button-engineer/Processor-on-Transistors/docs/ISA-and-opportunities-ALU.docx

Набір інструкцій та можливості ALU

Як я вже писав в цьому 4-бітному процесорі будуть 8-бітні інструкції. Ось приклад вигляду інструкції:

10110100

1011 – це команда (Opcode) наприклад команда додати ADD, саме за допомогою цих 4-х бітів процесор розуміє що потрібно робити. Так як на команду виділено 4 біта то максимум може існувати 16 команд.

01 – так як 1011 це команда додати то далі процесор має дізнатись які числа додавати, тому 01 це номер регістра з якимось числом, так як на номер виділено тільки 2 біти то всього буде 4 регістра.

00 – це також номер регістра з числом.

Але процесору ще потрібно кудась записати результат додавання, так як в інструкції більше немає зайвих бітів для позначення третього регістра для зберігання результату, процесор буде зберігати в перший регістр в інструкції тобто в регістр 01.

Далі в таблиці я розписав які команди будуть в цьому процесорі.

Команда | Назва | Синтаксис | Пояснення
0000 | NOP | NOP (00000000) | Нічого не робить, просто пропускає один такт, може використовуватись для затримок.
0001 | LD | LD R1 [R3] (00010100 00000011) | Команда яка передає число з SRAM в регістр. Комірка памʼяті SRAM позначається [Rn], n – це номер регістра. Так як з 8 біт інструкції 4 займає інструкція а 2 номер регістра то залишається ще 2 біти, але так як це дуже мало для памʼяті то номер регістра SRAM буде передаватись наступною інструкцією 8 біт, тобто всього доступно 256 регістрів SRAM.
0010 | ST | ST [R4] R2 (00100010 00000100) | Ця команда працює так само як і LD але передає число з регістра в SRAM.
0011 | ADD | ADD R0 R1 (00110001) | Команда що просто додає два 4-бітних числа з регістрів.
0100 | ADC | ADD R0 R1 (01000001) | Команда що додає два 4-бітних числа з регістрів враховуючи остачу минулого додавання.
0101 | SUB | SUB R0 R1 (01010001) | Команда для віднімання від значення з регістра 0 значення з регістра 1.
0110 | AND | AND R0 R1 (01100001) | Команда для виконання логічної операції AND над числами в регістрах 0 та 1.
0111 | OR | OR R0 R1 (01110001) | Команда для виконання логічної операції OR над числами в регістрах 0 та 1.
1000 | XOR | XOR R0 R1 (10000001) | Команда для виконання логічної операції XOR над числами в регістрах 0 та 1.
1001 | INC_DEC | INC_DEC R0 1/0 (10010001/0) | Команда що в залежності від числа в кінці інструкції додає або віднімає 1 від числа в вказаному регістрі і зберігає в той самий регістр.
1010 | SHF | SHF R0 1/0 (10100001/0) | Команда що в залежності від числа в кінці інструкції множить або ділить на два число в вказаному регістрі і зберігає в той самий регістр.
1011 | LDI | LDI R1 13 (10110100 00001101) | Команда що передає в вказаний регістр 4-бітне число, але так як в одній інструкції немає вільних 4-х біт то вони йдуть наступною інструкцією.
1100 | MOV | MOV R0 R1 (11000001) | Команда що переміщає число з регістра 1 в регістр 0.
1101 | JMP | JMP 123 (11010000 1100110) | Команда для перестрибування на інструкцію яка вказана в наступній інструкції, наприклад 123. Так як в процесорі буде 8-бітний лічильник в одній інструкції не вистачить вільних бітів для того щоб передати 8-бітне число, тому воно буде передаватись наступною інструкцією.
1110 | JZ | JZ R1 123 (11100100 1100110) | Команда також переносить на вказану інструкцію але за умови що в вказаному регістрі буде 0.
1111 | JC | JC 123 (11110000 1100110) | Команда також переносить на вказану інструкцію але за умови що після додавання буде переповнення.

Також спочатку я хотів добавити апаратне множення та ділення, але це виявилося доволі затратно по транзисторах, тому я вирішив програмно відтворювати ці дві операції.
