button-engineer/Processor-on-Transistors/(list of files, drawings)

Other design files:
schematics/74Microcircuit.circ
schematics/ALU.circ
schematics/CPU.circ
schematics/CPUwithMicrocircuits.circ
schematics/Registers.circ
schematics/ROMandCommandCounter.circ
