button-engineer/Processor-on-Transistors/docs/ROM, instruction counter, instruction register.docx

ROM, лічильник інструкцій, регістр інструкцій та реалізація команди Jump

Спочатку, при розробці цієї схеми я хотів просто зробити постійну пам’ять, лічильник інструкцій та регістр інструкцій, але при розробці я рішив глибше задуматись як саме буде працювати Jump і подібні до неї команди які виконуються за дві інструкції, і це мене привело до того що я доволі довго думав над цим механізмом роботи схеми.

Спочатку розкажу про саму схему яка представлена на рисунку 1 та її компоненти.

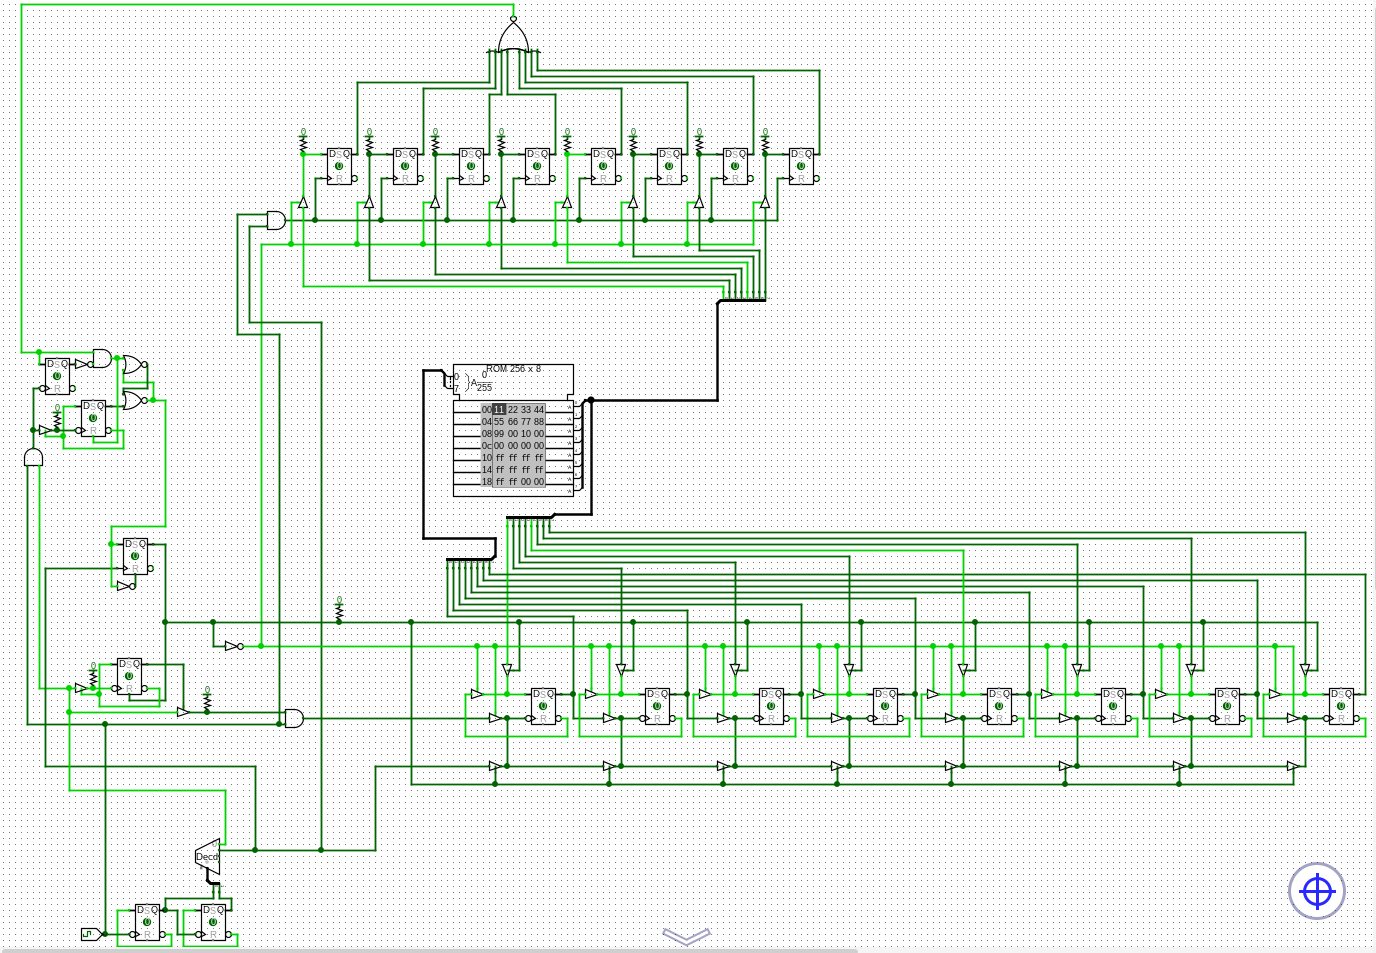
[picture p11: figure]

Рисунок 1

В нижньому лівому куті стоїть те без чого ніяка цифрова електроніка не працює, це генератор тактового сигналу. В більшості процесорів цей генератор є звичайним і за один такт виконується наприклад одна інструкція, але так як мій процесор буде на РТЛ логіці яка сама по собі є доволі повільною відносно інших, тому я рішив розділити одне виконання інструкції на декілька тактів, щоб логічні вентилі встигали переключитись. Тобто наприклад візьмемо інструкцію ADD, перший такт переключає лічильник інструкцій, другий записує інструкцію в регістр інструкцій і подає на шину числа з вибраних регістрів, третій такт обробляє дані в ALU, а на четвертий такт результат записується в регістр. І так всі інструкції можна буде виконувати за чотири такти, чотири через те що лічильник стоїть 2-бітний. Деякі інструкції не будуть потребувати чотири такти для їх виконання, тому можна буде скидати лічильник тактів, і за допомогою цього збільшити швидкість процесора, також можна виконувати інструкції на обчислення за три такти об’єднавши обчислення та запис в регістр в один такт, але для цього прискорення потрібні ще транзистори, ну і в мене на меті немає зробити максимально швидкий процесор, а просто робочий, я ще подумаю чи потрібно його прискорювати.

Далі про лічильник інструкцій, він розташований під ROM. Це 8-бітний регістр в якого є два режима, це режим лічильника який рахує тактові імпульси, і режим регістра в який записується число з постійної пам’яті. Ці режими переключаються за допомогою механізму про який трішки потім.

По центрі розташована мікросхема постійної пам’яті. В своєму проекті я буду використовувати мікросхему AT28C64, вона може містити 64кбіт по 8 біт слово. Так як я буду використовувати 8-бітний лічильник то всього процесорі буде доступно 256 інструкцій в пам’яті.

Зверху над пам’яттю розташований регістр інструкцій. Він призначений для зберігання основної інструкції поки не буде повністю виконана команд. Без нього було б не можливо реалізувати команди які виконуються за дві інструкції.

На самому верху стоїть 8NOR який виконує функцію дешифратора в реальному процесорі. Тобто код команди Jump це 1101, але тут для того щоб не ставити дешифратор я просто використав NOR, і тепер механізм для Jump включається при інструкції 00000000.

А тепер про сам механізм для роботи з командами на дві інструкції. Для розуміння як він працює потрібно розписати кроки роботи команди Jump:

1. Після того як лічильник переключився на інструкцію з командою Jump, вона записується в регістр інструкцій і на далі запис в цей регістр блокується.
2. Далі тактовий генератор додає один до лічильника інструкцій, і на виході постійної пам’яті появляється інструкція з числом яке має записатись в лічильник.
3. Потім при наступному такті відкриваються ключі для запису в лічильник, і закриваються ключі для додавання, тобто лічильник переходить в режим регістра. На цьому ж такті відбувається запис числа з пам’яті в лічильник.
4. Тепер пам’ять переключається на інструкцію за номером який записався в лічильник. Наступний такт закриває ключі на перезапис лічильника і відкриває для додавання, але не додає так як потрібно відпрацювати цю інструкцію за записаним номером.
5. І останній крок це нова інструкція записується в регістр інструкцій і виконується.
