button-engineer/Processor-on-Transistors/docs/History-and-plans.docx

Історія і плани

Почну з історії як я рішив зробити цей проект. Гортаючи тікток я наткнувся на відео де якийсь програміст зробив 8-бітний процесор в Logisim, мені це здалося дуже круто, також він зробив свою мову для програмування цього процесора. Я впринципі розумів як він працює тому мені здалось що буде цікаво також зробити процесор, але не переробити його з інтернету як він а повністю придумати його архітектуру з нуля і плюс відтворити його в реальності на транзисторах.

Тепер до планів(вони можуть час від часу мінятись так як по ходу роботи я можу замічати недоліки того що я тут написав). По перше я б хотів згадати про найважливіше це архітектура процесора, її в мене не буде так як я буду її придумувати сам. Друге це розрядність процесора, на початку я думав зробити 8-бітний процесор, але потім як трішки в цьому розібрався я зрозумів що в фізичному виконані цей процесор буде потребувати занадто багато транзисторів і тому рішив що краще зробити 4-бітний процесор, хоч він буде малим для великих обрахунків, але як показниковий проект цього буде достатньо. Інструкції я буду використовувати 8-бітні. Буде 4 4-бітних регістра та можливо SRAM памʼять, а саме мікросхема AS6C62256, але поки що я не впевнений чи вона потрібна так як потрібно буде виділити під неї дві інструкції на запис з регістра в памʼять та на читання з памʼяті в регістр. Для коду процесора я планую використовувати мікросхему памʼяті EEPROM AT28C64 та 8-бітний лічильник для вибору команд, тобто всього буде 256 команд.
