button-engineer/Processor-on-Transistors/(commit log)

2026-08-08 Added register and counter schematics
    [ROMandCommandCounter.circ, Registers.circ]
2026-08-13 Updated the Registers and made a schematic with the EEPROM and the command counter
    [ROMandCommandCounter.circ, Registers.circ]
2026-08-15 Changed the register scheme and added its description
    [Registers.circ]
2026-08-25 Added ALU and ROM instruction circuit, also improved Registers and ROM circuits
    [ALU.circ, ROMandCommandCounter.circ, Registers.circ]
2026-08-28 Added doc ALU and fix one problem in schematic ALU
    [ALU.circ]
2026-08-31 Added CPU
    [CPU.circ]
2026-09-03 Finished CPU in Logisim
    [ALU.circ, CPU.circ]
2026-09-08 Added CPU document and Microcircuits
    [74Microcircuit.circ, CPU.circ, CPUwithMicrocircuits.circ]
2026-09-17 Added CPUwithmicrocircuits
    [74Microcircuit.circ, CPU.circ, CPUwithMicrocircuits.circ]
